bluepylons/Project-152-Bass-Guitar-Amp/panel-connections.txt

Front panel:

(switch)     Power
(5mm LED)    Power
(5mm LED)    Overload
(1/4" jack)  Guitar-in
(switch)     Gain
(knob)       Gain
(knob)       Master Volume

(switch)     Mute 
(switch)     High-pass filter
(switch)     High-pass filter frequency 

(1/8" jack)  Aux in
(1/8" jack)  Headphone out
(knob)       Headphone volume

(knob)       DI send level

Front panel (EQ)
(switch)     Bass peak/shelf
(knob)       Bass level
(knob)       Bass center frequency
(knob)       Low-mid level 
(knob)       Low-mid frequency
(knob)       High-mid level
(knob)       High-mid frequency
(knob)       Treble level
(knob)       Treble frequency

Back panel:		Depth 
(1/4" jack)      EFX out
(1/4" jack)      EFX in
(switch)         DI source 
(switch)         DI ground lift
(XLR)            DI 
(knob)           Balance 
(knob)           Frequency 
(1/4" jack)      Tuner
(IEC connector)  Power In
(1/4" jack)      Woofer
(1/4" jack)      Mids
(1/4" jack)      Tweeter
(Speak-On)       Unified Woofer+Mids

Raw:
Guitar In (1/4" jack)
Power (LED)
Overload (LED)

DI out (XLR)
DI select (switch)
DI ground lift (switch)

Highs (1/4"
Lows (1/4")
Tweeter (1/4"

Gain Sw (toggle sw)
Gain pot (dual 10K)
HPF Bypass (dual switch)
HPF Frequency (dual switch)
EFX Send (1/4" jack) 
EFX Return (1/4" jack)
Aux In (3.5mm jack)
Headphone Out (3.5mm jack)
Tuner Out (1/4" jack)
