bluepylons/Project-152-Bass-Guitar-Amp/Semiparametric-EQ/Semiparametric-EQ 2-22.step

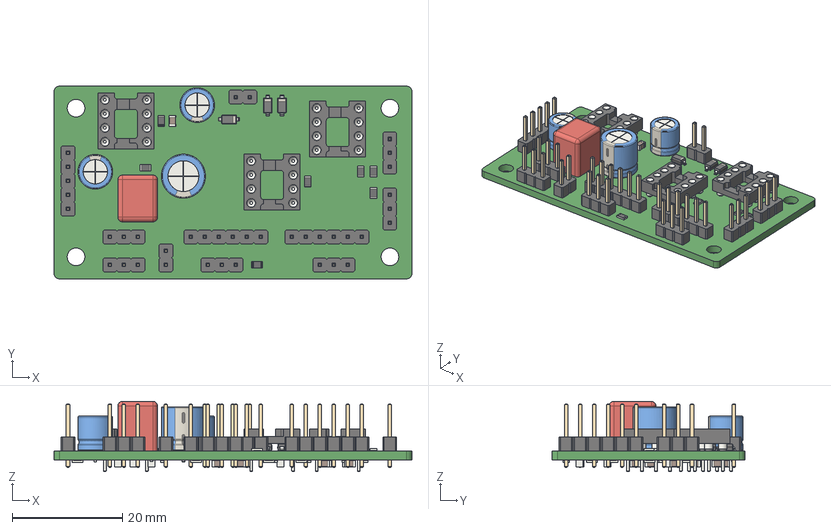
[picture p1: CAD file, 2020-02-23]
Semiparametric-EQ/Semiparametric-EQ 2-22.step
65.0 x 35.0 x 12.8 mm
