bluepylons/Project-152-Bass-Guitar-Amp/power_supply/power_supply.kicad_pcb

## KiCad design power_supply/power_supply.kicad_pcb (2020-02-27)

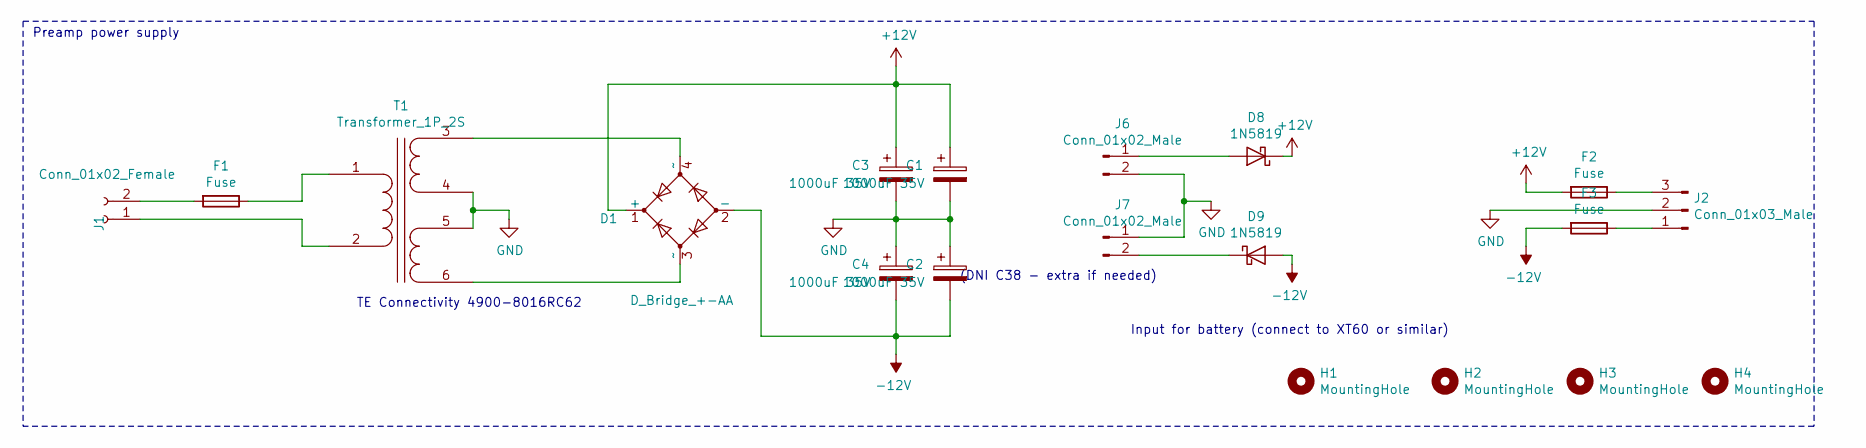
[picture p2: schematic power_supply.sch]

Parts:
C1, C2, C3, C4: 1000uF 35V; CP_Radial_D10.0mm_P5.00mm
D1: D_Bridge_+-AA; DiodesIncDF-M
D8, D9: 1N5819; D_DO-41_SOD81_P10.16mm_Horizontal
F1: Fuse; Keystone-3527-Fuseholder
F2, F3: Fuse; Fuseholder_Blade_Mini_Keystone_3568
H1, H2, H3, H4: MountingHole; MountingHole_3.2mm_M3_DIN965
J1: Conn_01x02_Female; TerminalBlock_Dinkle_DT-55-B01X-02_P10.00mm
J2: Conn_01x03_Male; PinHeader_1x03_P2.54mm_Vertical
J6, J7: Conn_01x02_Male; TerminalBlock_Phoenix_PT-1,5-2-5.0-H_1x02_P5.00mm_Horizontal
T1: Transformer_1P_2S; TE490080XXRC62

Connections:
+12V: C1.1, C3.1, D1.1 (+), D8.1 (K), F2.2
-12V: C2.2, C4.2, D1.2 (-), D9.2 (A), F3.2
GND: C1.2, C2.1, C3.2, C4.1, J2.2, J6.2, J7.1, T1.4 (SB), T1.5 (SC)
unnamed: D1.3 (~~), T1.6 (SD)
unnamed: D1.4 (~~), T1.3 (SA)
unnamed: D8.2 (A), J6.1
unnamed: D9.1 (K), J7.2
unnamed: F1.1, T1.1 (AA)
unnamed: F1.2, J1.2
unnamed: F2.1, J2.3
unnamed: F3.1, J2.1
unnamed: J1.1, T1.2 (AB)

Notes on the sheet:
TE Connectivity 4900-8016RC62
Input for battery (connect to XT60 or similar)
Preamp power supply
(DNI C38 - extra if needed)

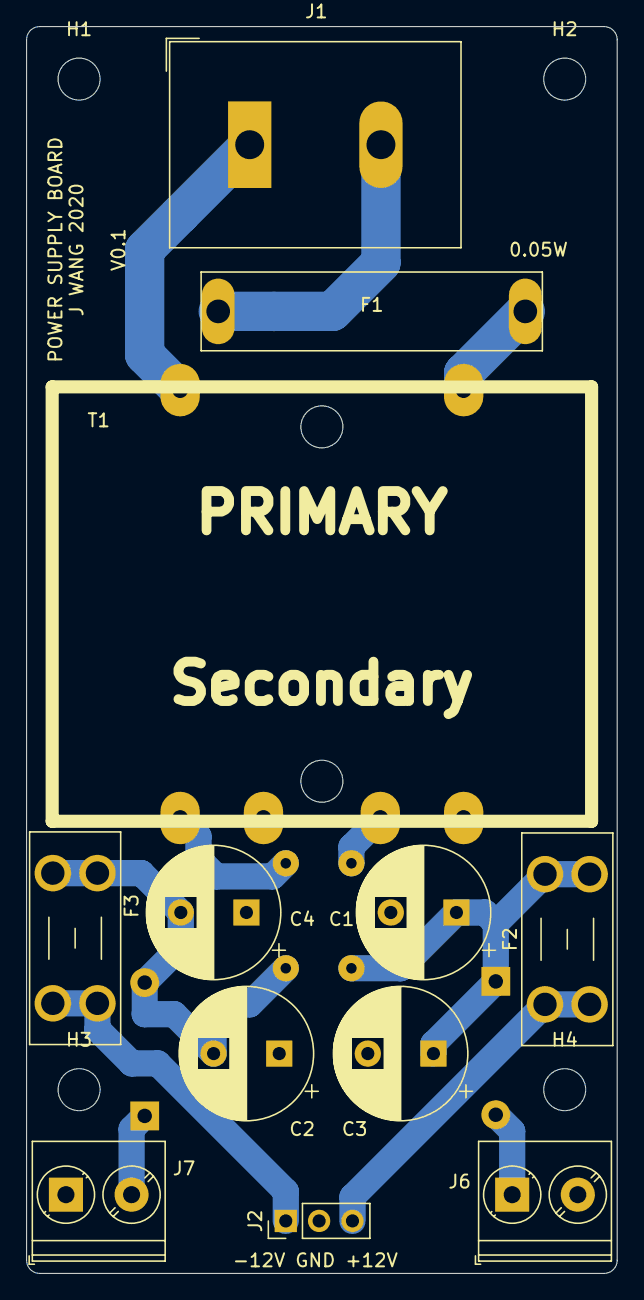
[picture p3: board power_supply.kicad_pcb from above]

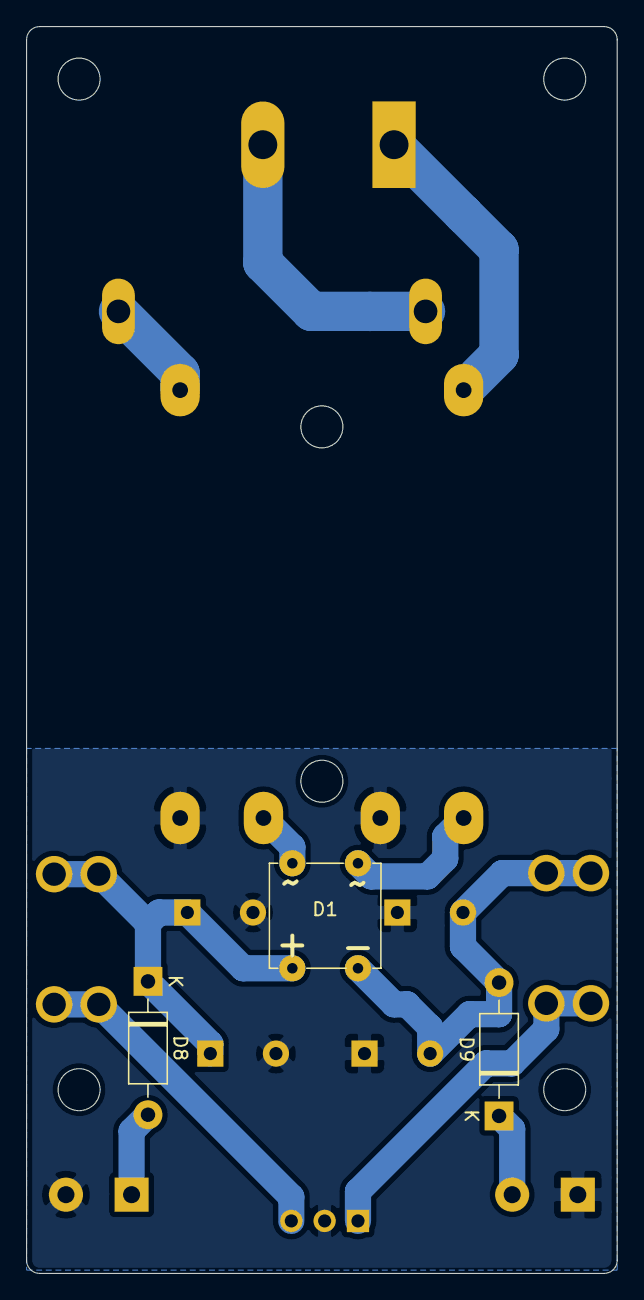
[picture p4: board power_supply.kicad_pcb from below]

Board: 2 copper layers, 45.0 x 95.0 mm, 19 parts (3 on the bottom side), 12 nets.
