bluepylons/Project-152-Bass-Guitar-Amp/Preamp/Preamplifier.kicad_pcb

## KiCad design Preamp/Preamplifier.kicad_pcb (2020-02-23)

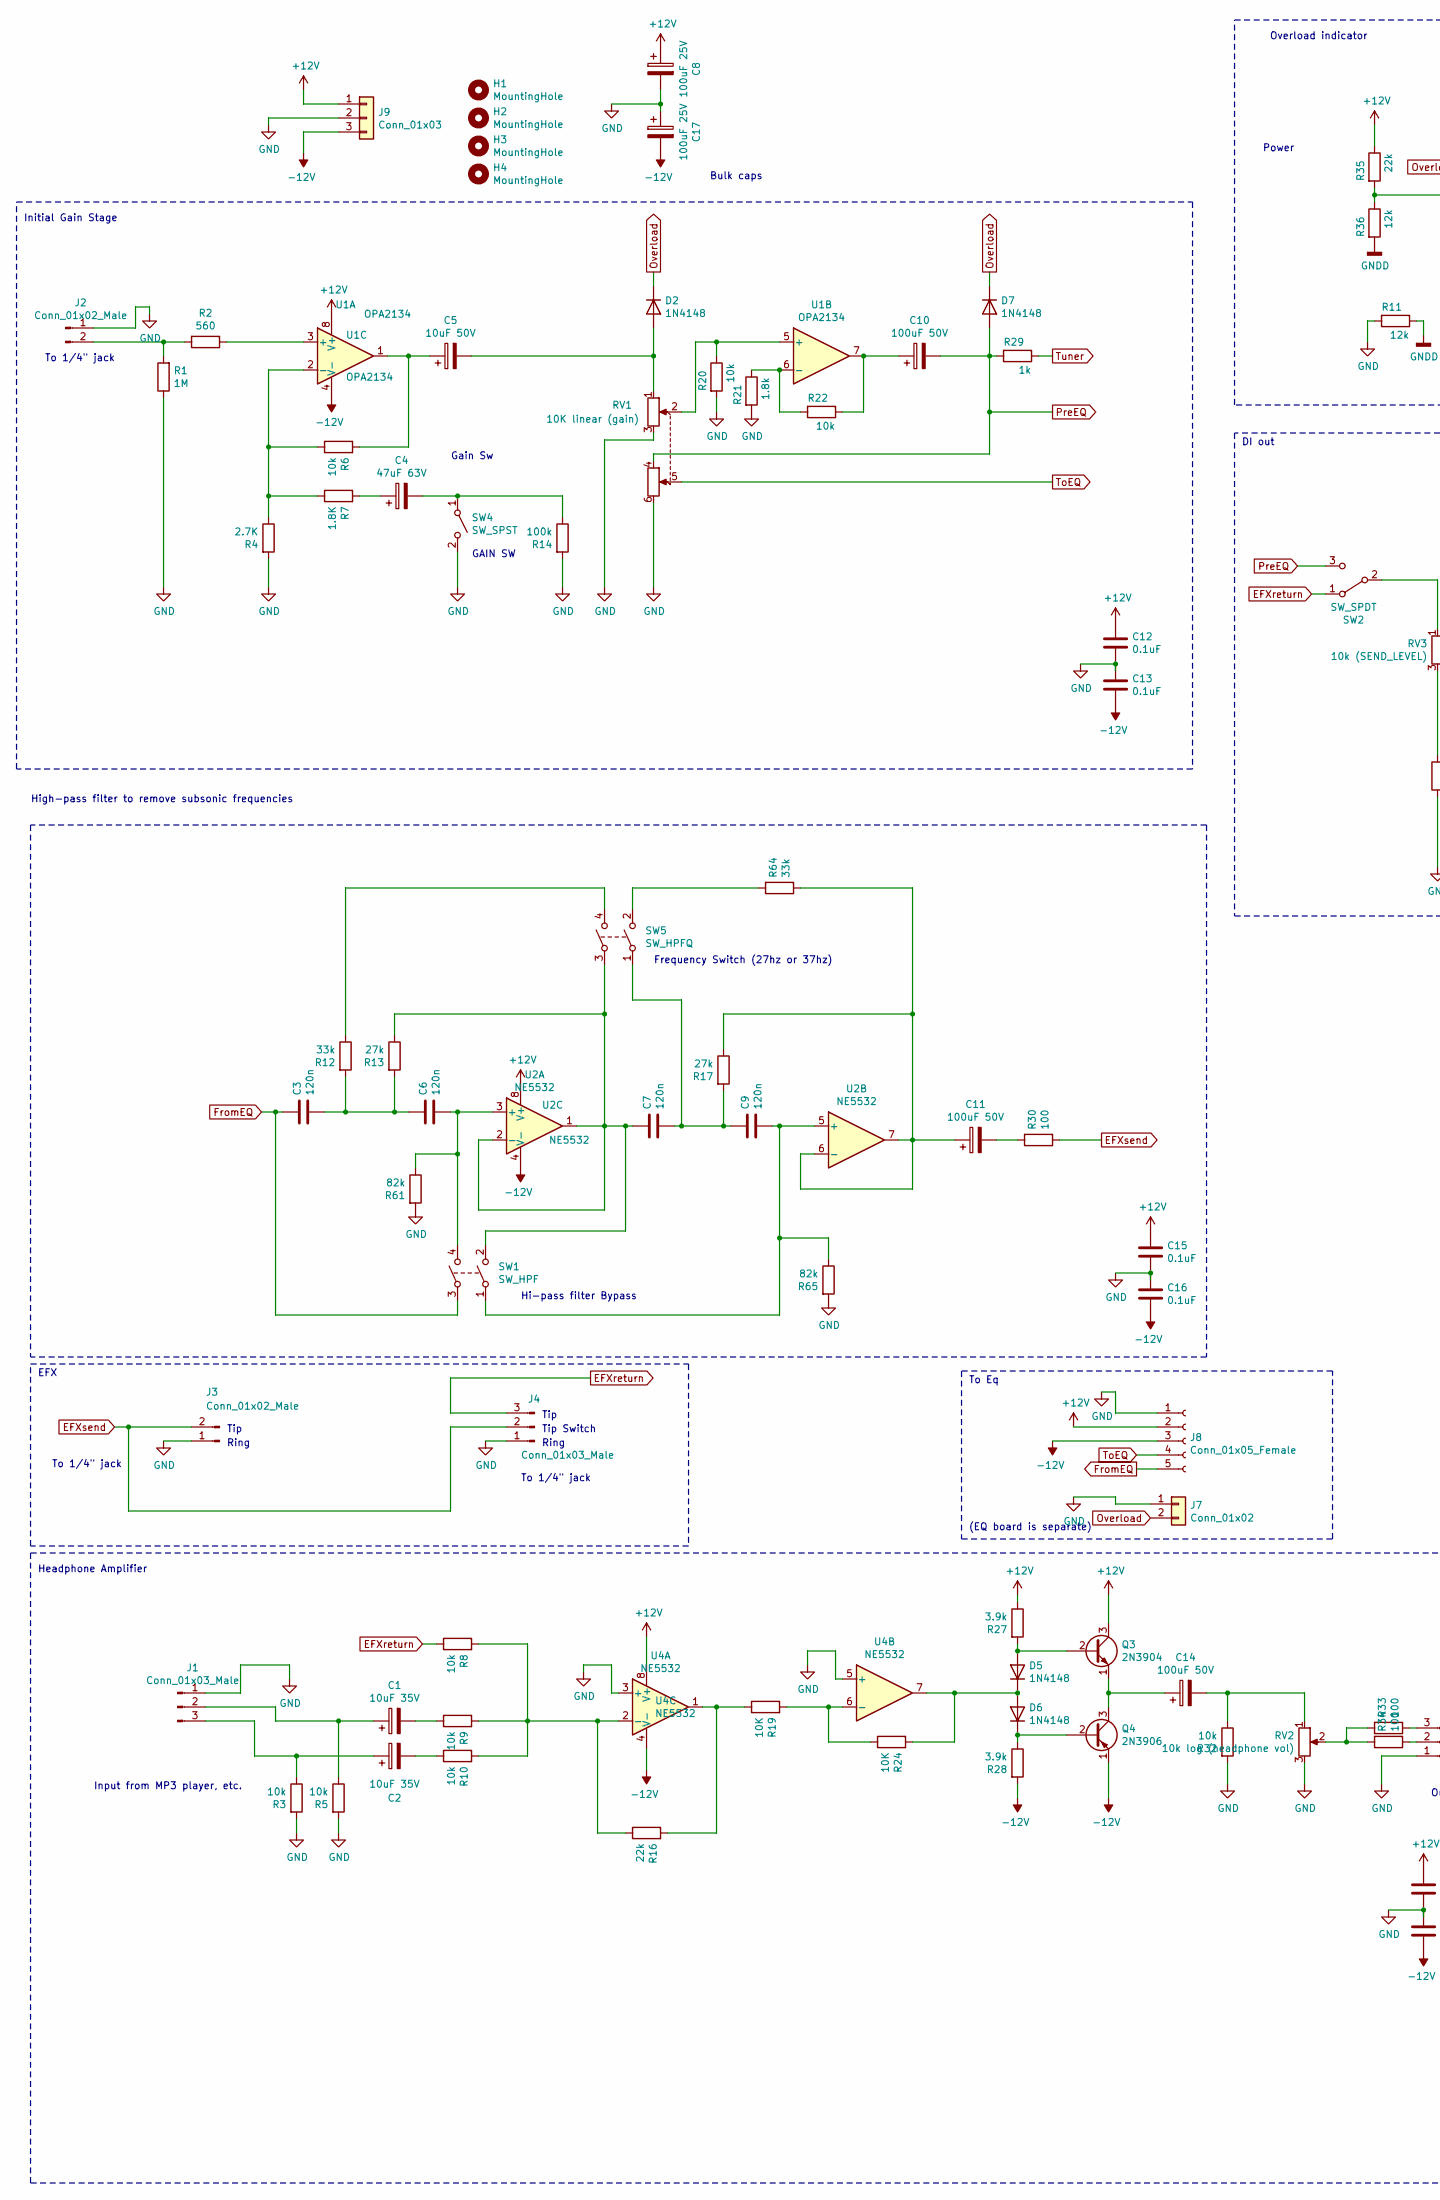
[picture p5: schematic Preamplifier.kicad_sch, part in row 1, column 1]

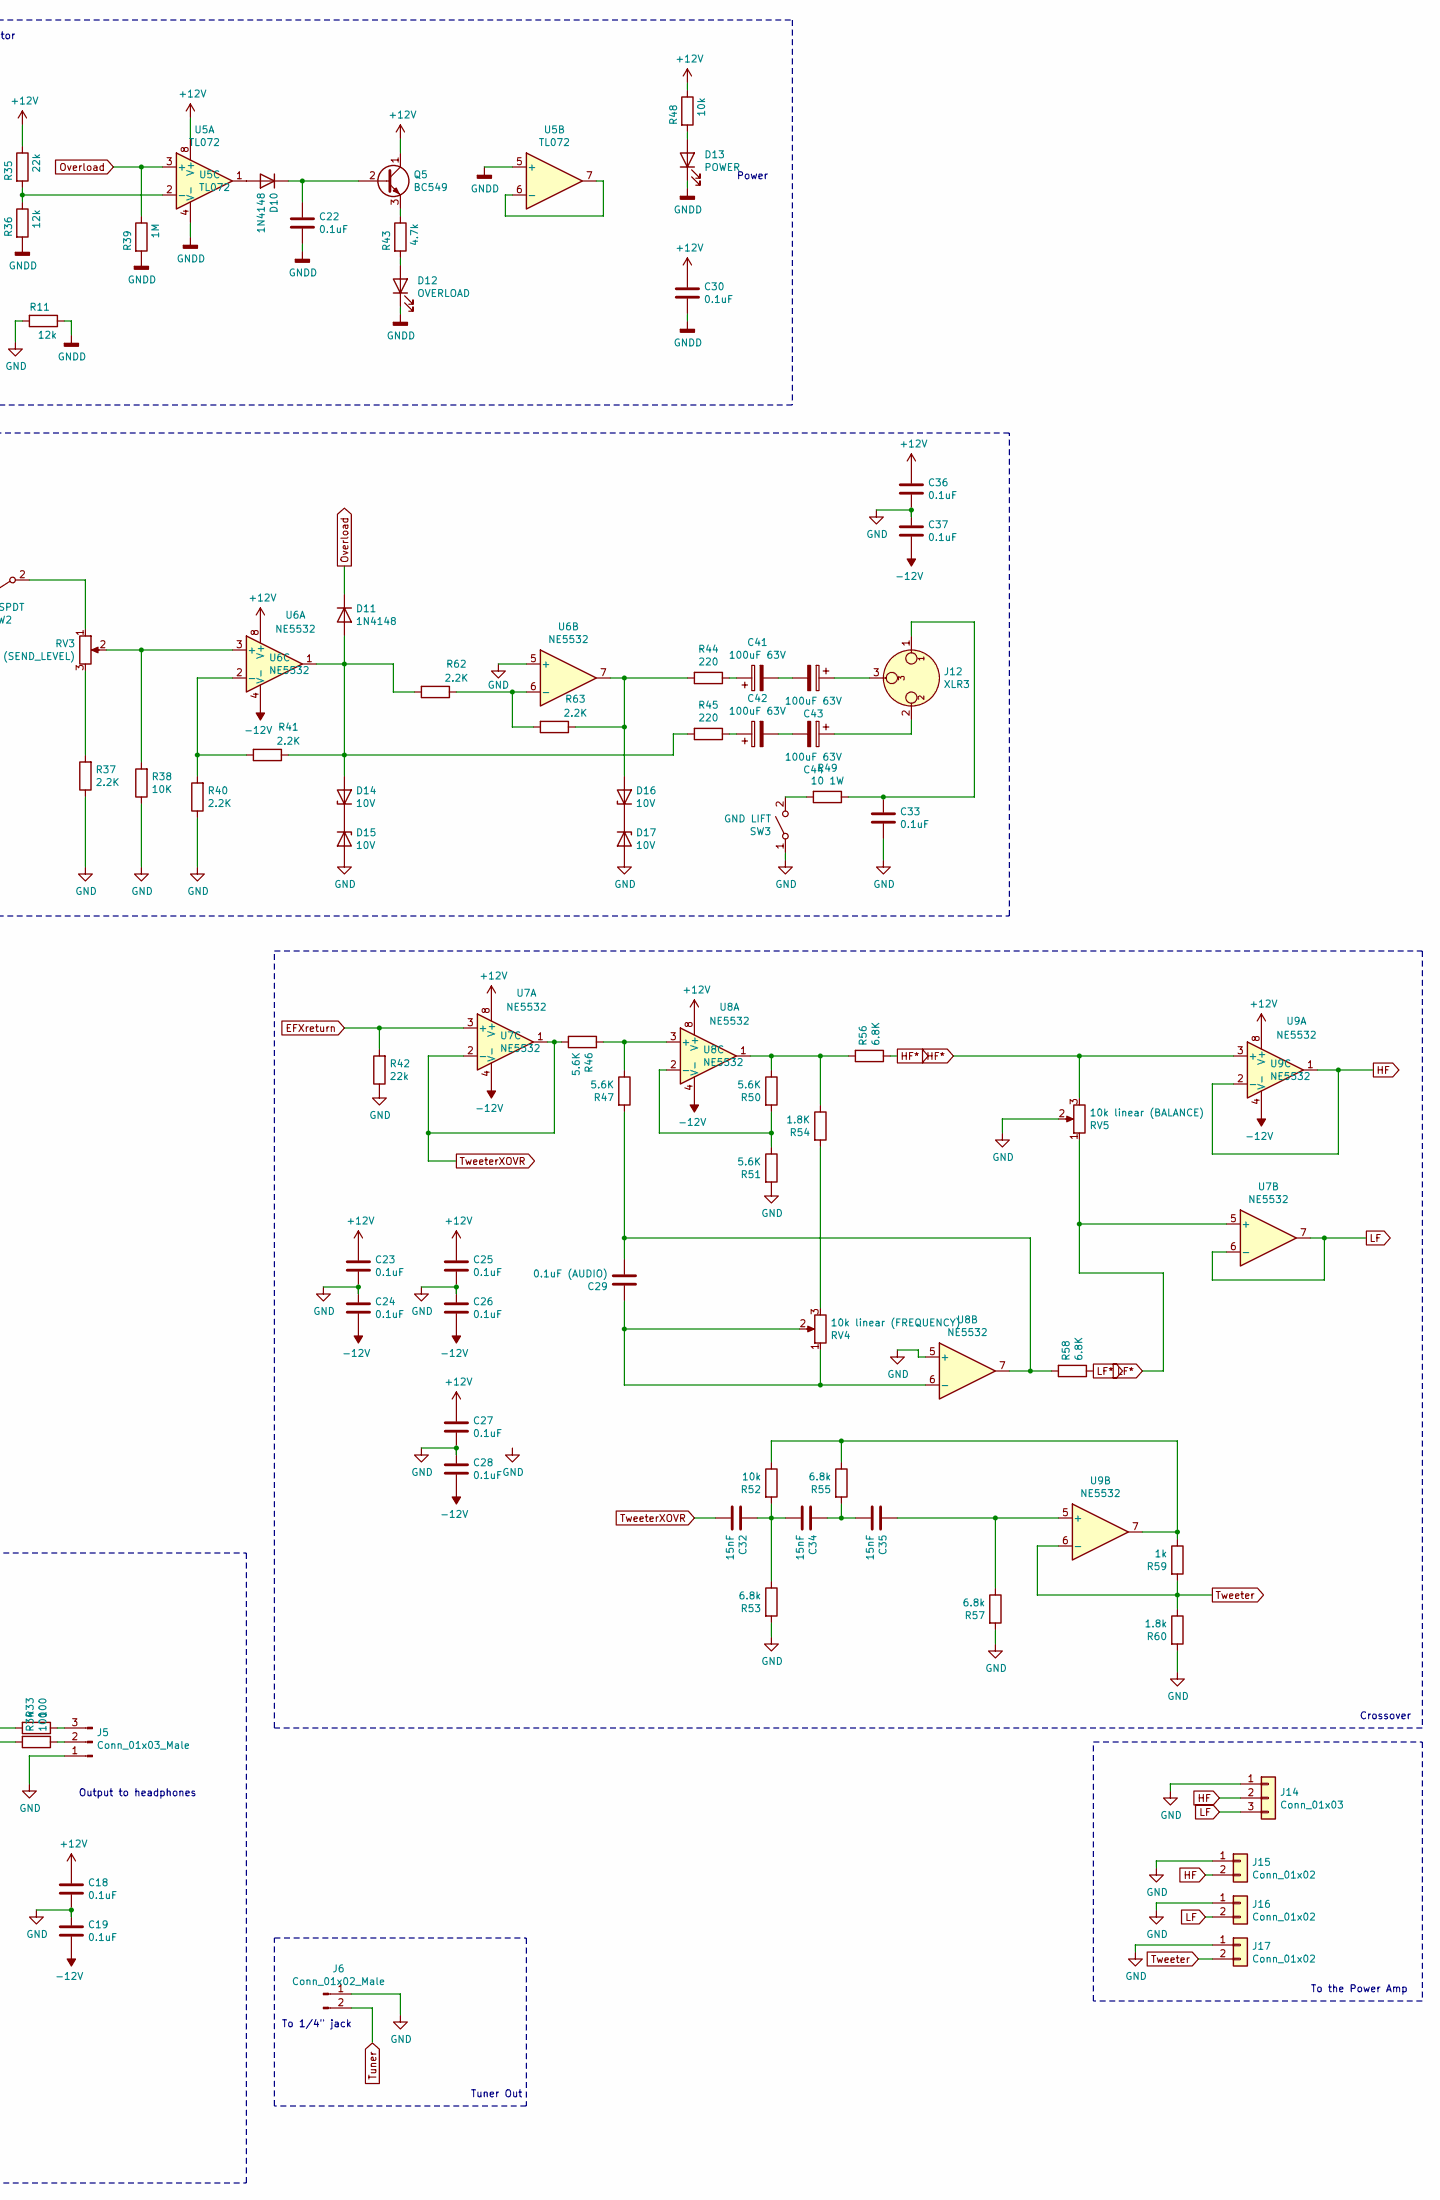
[picture p6: schematic Preamplifier.kicad_sch, part in row 1, column 2]

Parts:
C1, C2: 10uF 35V; CP_Radial_D5.0mm_P2.00mm
C3, C6, C7, C9: 120n; C_Rect_L7.2mm_W3.5mm_P5.00mm_FKS2_FKP2_MKS2_MKP2
C4: 47uF 63V; CP_Radial_D8.0mm_P5.00mm
C5: 10uF 50V; CP_Radial_D6.3mm_P2.50mm
C8, C17: 100uF 25V; CP_Radial_D6.3mm_P2.50mm
C10, C11: 100uF 50V; CP_Radial_D8.0mm_P3.50mm
C12, C13, C15, C16, C18, C19, C22, C23, C24, C25, C26, C27, C28, C30, C33, C36, C37: 0.1uF; C_0805_2012Metric_Pad1.15x1.40mm_HandSolder
C14: 100uF 50V; CP_Radial_D8.0mm_P2.50mm
C29: 0.1uF (AUDIO); C_Rect_L7.2mm_W2.5mm_P5.00mm_FKS2_FKP2_MKS2_MKP2
C32, C34, C35: 15nF; C_Rect_L7.2mm_W2.5mm_P5.00mm_FKS2_FKP2_MKS2_MKP2
C41, C42, C43, C44: 100uF 63V; CP_Radial_D8.0mm_P3.50mm
D2, D5, D6: 1N4148; D_SOD-123
D7, D10, D11: 1N4148; D_DO-35_SOD27_P7.62mm_Horizontal
D12: OVERLOAD; LED_D3.0mm
D13: POWER; LED_D3.0mm
D14, D15, D16, D17: 10V; D_DO-41_SOD81_P7.62mm_Horizontal
H1, H2, H3, H4: MountingHole; MountingHole_3.2mm_M3_ISO7380
J1, J4, J5: Conn_01x03_Male; PinHeader_1x03_P2.54mm_Vertical
J2, J3, J6: Conn_01x02_Male; PinHeader_1x02_P2.54mm_Vertical
J7, J15, J16, J17: Conn_01x02; PinHeader_1x02_P2.54mm_Vertical
J8: Conn_01x05_Female; PinHeader_1x05_P2.54mm_Vertical
J9, J14: Conn_01x03; PinHeader_1x03_P2.54mm_Vertical
J12: XLR3; PinHeader_1x03_P2.54mm_Vertical
Q3: 2N3904; TO-92_Inline
Q4: 2N3906; TO-92_Inline
Q5: BC549; TO-92_Inline
R1, R39: 1M; R_0805_2012Metric_Pad1.15x1.40mm_HandSolder
R2: 560; R_0805_2012Metric_Pad1.15x1.40mm_HandSolder
R3, R5, R6, R8, R9, R10, R20, R22, R32, R48, R52: 10k; R_0805_2012Metric_Pad1.15x1.40mm_HandSolder
R4: 2.7K; R_0805_2012Metric_Pad1.15x1.40mm_HandSolder
R7, R54: 1.8K; R_0805_2012Metric_Pad1.15x1.40mm_HandSolder
R11, R36: 12k; R_0805_2012Metric_Pad1.15x1.40mm_HandSolder
R12, R64: 33k; R_0805_2012Metric_Pad1.15x1.40mm_HandSolder
R13, R17: 27k; R_0805_2012Metric_Pad1.15x1.40mm_HandSolder
R14: 100k; R_0805_2012Metric_Pad1.15x1.40mm_HandSolder
R16, R35, R42: 22k; R_0805_2012Metric_Pad1.15x1.40mm_HandSolder
R19, R24, R38: 10K; R_0805_2012Metric_Pad1.15x1.40mm_HandSolder
R21, R60: 1.8k; R_0805_2012Metric_Pad1.15x1.40mm_HandSolder
R27, R28: 3.9k; R_0805_2012Metric_Pad1.15x1.40mm_HandSolder
R29, R59: 1k; R_0805_2012Metric_Pad1.15x1.40mm_HandSolder
R30, R33, R34: 100; R_1206_3216Metric_Pad1.42x1.75mm_HandSolder
R37, R40, R41, R62, R63: 2.2K; R_0805_2012Metric_Pad1.15x1.40mm_HandSolder
R43: 4.7k; R_0805_2012Metric_Pad1.15x1.40mm_HandSolder
R44, R45: 220; R_1206_3216Metric_Pad1.42x1.75mm_HandSolder
R46, R47, R50, R51: 5.6K; R_0805_2012Metric_Pad1.15x1.40mm_HandSolder
R49: 10 1W; R_Axial_DIN0411_L9.9mm_D3.6mm_P12.70mm_Horizontal
R53, R55, R57: 6.8k; R_0805_2012Metric_Pad1.15x1.40mm_HandSolder
R56, R58: 6.8K; R_0805_2012Metric_Pad1.15x1.40mm_HandSolder
R61, R65: 82k; R_0805_2012Metric_Pad1.15x1.40mm_HandSolder
RV1: 10K linear (gain); PinHeader_1x06_P2.54mm_Vertical
RV2: 10k log (headphone vol); PinHeader_1x03_P2.54mm_Vertical
RV3: 10k (SEND_LEVEL); PinHeader_1x03_P2.54mm_Vertical
RV4: 10k linear (FREQUENCY); RM-065-TRIMPOT
RV5: 10k linear (BALANCE); RM-065-TRIMPOT
SW1: SW_HPF; PinHeader_2x02_P2.54mm_Vertical
SW2: SW_SPDT; PinHeader_1x03_P2.54mm_Vertical
SW3: GND LIFT; PinHeader_1x02_P2.54mm_Vertical
SW4: SW_SPST; PinHeader_1x02_P2.54mm_Vertical
SW5: SW_HPFQ; PinHeader_2x02_P2.54mm_Vertical
U1: OPA2134; DIP-8_W7.62mm_Socket
U2, U4, U6, U7, U8, U9: NE5532; DIP-8_W7.62mm_Socket
U5: TL072; DIP-8_W7.62mm_Socket

Connections:
+12V: C8.1, C12.2, C15.2, C18.2, C23.2, C25.2, C27.2, C30.2, C36.2, J8.2, J9.1, Q3.3 (C), Q5.1 (C), R27.1, R35.1, R48.1, U1.8 (V+), U2.8 (V+), U4.8 (V+), U5.8 (V+), U6.8 (V+), U7.8 (V+), U8.8 (V+), U9.8 (V+)
-12V: C13.1, C16.1, C17.2, C19.1, C24.1, C26.1, C28.1, C37.1, J8.3, J9.3, Q4.1 (E), R28.2, U1.4 (V-), U2.4 (V-), U4.4 (V-), U6.4 (V-), U7.4 (V-), U8.4 (V-), U9.4 (V-)
EFXreturn: J4.3, R8.1, R42.2, SW2.1 (A), U7.3 (+)
EFXsend: J3.2, J4.2, R30.1
FromEQ: C3.2, J8.5, SW1.3
GND: C8.2, C12.1, C13.2, C15.1, C16.2, C17.1, C18.1, C19.2, C23.1, C24.2, C25.1, C26.2, C27.1, C28.2, C33.1, C36.1, C37.2, D15.2 (A), D17.2 (A), J1.1, J2.1, J3.1, J4.1, J5.1, J6.1, J7.1, J8.1, J9.2, J14.1, J15.1, J16.1, J17.1, R1.1, R3.2, R4.2, R5.2, R11.2, R14.2, R20.2, R21.2, R32.2, R37.1, R38.1, R40.1, R42.1, R51.2, R53.2, R57.2, R60.2, R61.2, R65.2, RV1.3, RV1.6, RV2.3, RV5.2, SW3.1 (A), SW4.2 (B), U4.3 (+), U4.5 (+), U6.5 (+), U8.5 (+)
GNDD: C22.1, C30.1, D12.1 (K), D13.1 (K), R11.1, R36.2, R39.2, U5.4 (V-), U5.5 (+)
HF: J14.2, J15.2, U9.1, U9.2 (-)
HF*: R56.1, RV5.3, U9.3 (+)
LF: J14.3, J16.2, U7.6 (-), U7.7
LF*: R58.1, RV5.1, U7.5 (+)
unnamed: C1.1, J1.2, R5.1
unnamed: C1.2, R9.1
unnamed: C2.1, J1.3, R3.1
unnamed: C2.2, R10.1
unnamed: C3.1, C6.2, R12.2, R13.2
unnamed: C4.1, R7.2
unnamed: C4.2, R14.1, SW4.1 (A)
unnamed: C5.1, R6.2, U1.1
unnamed: C5.2, D2.2 (A), RV1.1
unnamed: C6.1, R61.1, SW1.4, U2.3 (+)
unnamed: C7.1, C9.2, R17.2, SW5.1
unnamed: C7.2, R13.1, SW1.2, SW5.3, U2.1, U2.2 (-)
unnamed: C9.1, R65.1, SW1.1, U2.5 (+)
unnamed: C10.1, R22.1, U1.7
unnamed: C11.1, R17.1, R64.1, U2.6 (-), U2.7
unnamed: C11.2, R30.2
unnamed: C14.1, Q3.1 (E), Q4.3 (C)
unnamed: C14.2, R32.1, RV2.1
unnamed: C22.2, D10.1 (K), Q5.2 (B)
unnamed: C29.1, R47.2, R58.2, U8.7
unnamed: C29.2, RV4.1, RV4.2, U8.6 (-)
unnamed: C32.2, C34.1, R52.2, R53.1
unnamed: C33.2, J12.1, R49.1
unnamed: C34.2, C35.1, R55.2
unnamed: C35.2, R57.1, U9.5 (+)
unnamed: C41.1, R44.1
unnamed: C41.2, C43.2
unnamed: C42.1, R45.1
unnamed: C42.2, C44.2
unnamed: C43.1, J12.3
unnamed: C44.1, J12.2
unnamed: D5.1 (K), D6.2 (A), R24.2, U4.7
unnamed: D5.2 (A), Q3.2 (B), R27.2
unnamed: D6.1 (K), Q4.2 (B), R28.1
unnamed: D10.2 (A), U5.1
unnamed: D11.2 (A), D14.2 (A), R41.1, R45.2, R62.2, U6.1
unnamed: D12.2 (A), R43.2
unnamed: D13.2 (A), R48.2
unnamed: D14.1 (K), D15.1 (K)
unnamed: D16.1 (K), D17.1 (K)
unnamed: D16.2 (A), R44.2, R63.1, U6.7
unnamed: J2.2, R1.2, R2.2
unnamed: J5.2, R34.1
unnamed: J5.3, R33.1
unnamed: Q5.3 (E), R43.1
unnamed: R2.1, U1.3 (+)
unnamed: R4.1, R6.1, R7.1, U1.2 (-)
unnamed: R8.2, R9.2, R10.2, R16.1, U4.2 (-)
unnamed: R12.1, SW5.4
unnamed: R16.2, R19.1, U4.1
unnamed: R19.2, R24.1, U4.6 (-)
unnamed: R20.1, RV1.2, U1.5 (+)
unnamed: R21.1, R22.2, U1.6 (-)
unnamed: R33.2, R34.2, RV2.2
unnamed: R35.2, R36.1, U5.2 (-)
unnamed: R37.2, RV3.3
unnamed: R38.2, RV3.2, U6.3 (+)
unnamed: R40.2, R41.2, U6.2 (-)
unnamed: R46.2, R47.1, U8.3 (+)
unnamed: R49.2, SW3.2 (B)
unnamed: R50.1, R54.1, R56.2, U8.1
unnamed: R50.2, R51.1, U8.2 (-)
unnamed: R52.1, R55.1, R59.1, U9.7
unnamed: R54.2, RV4.3
unnamed: R62.1, R63.2, U6.6 (-)
unnamed: R64.2, SW5.2
unnamed: RV3.1, SW2.2 (B)
unnamed: U5.6 (-), U5.7
Overload: D2.1 (K), D7.1 (K), D11.1 (K), J7.2, R39.1, U5.3 (+)
PreEQ: C10.2, D7.2 (A), R29.2, RV1.4, SW2.3 (C)
ToEQ: J8.4, RV1.5
Tuner: J6.2, R29.1
Tweeter: J17.2, R59.2, R60.1, U9.6 (-)
TweeterXOVR: C32.1, R46.1, U7.1, U7.2 (-)

Notes on the sheet:
Initial Gain Stage
High-pass filter to remove subsonic frequencies
EFX
Headphone Amplifier
To 1/4" jack
Input from MP3 player, etc.
Tip
Ring
Gain Sw
GAIN SW
Hi-pass filter Bypass
Tip Switch
Frequency Switch (27hz or 37hz)
Bulk caps
To Eq
(EQ board is separate)
DI out
Power
Overload indicator
Output to headphones
Tuner Out
To the Power Amp
Crossover

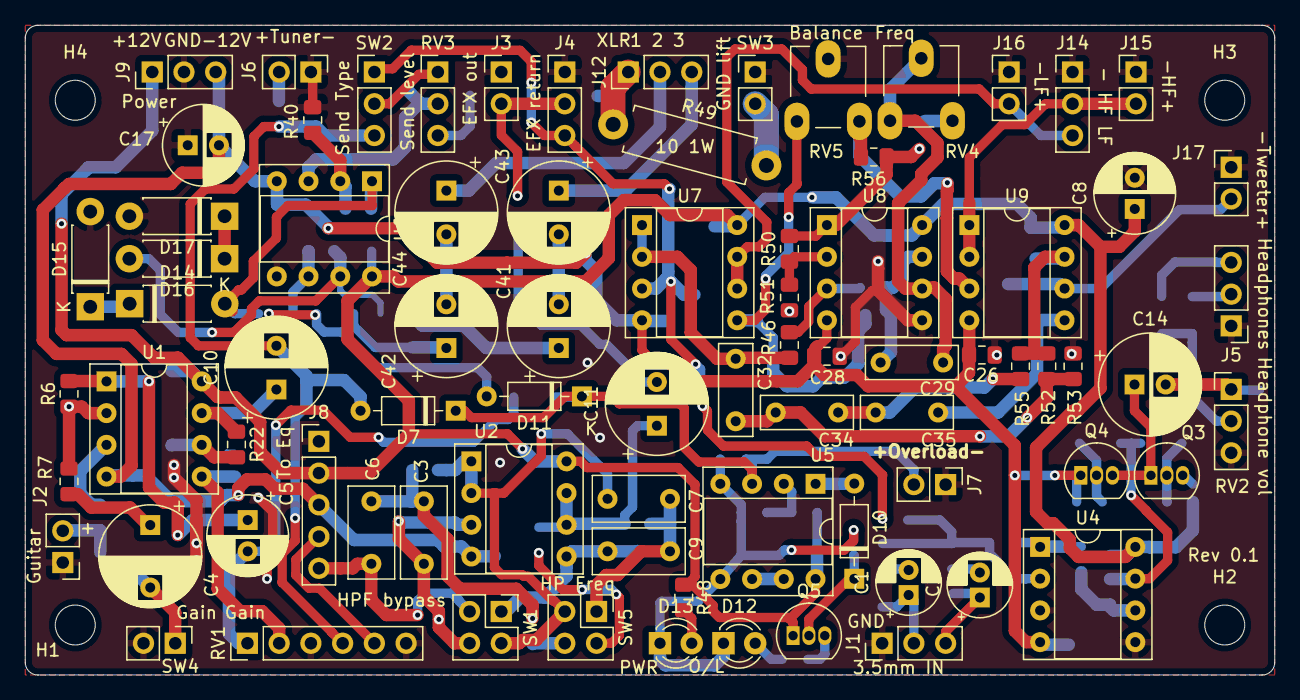
[picture p7: board Preamplifier.kicad_pcb from above]

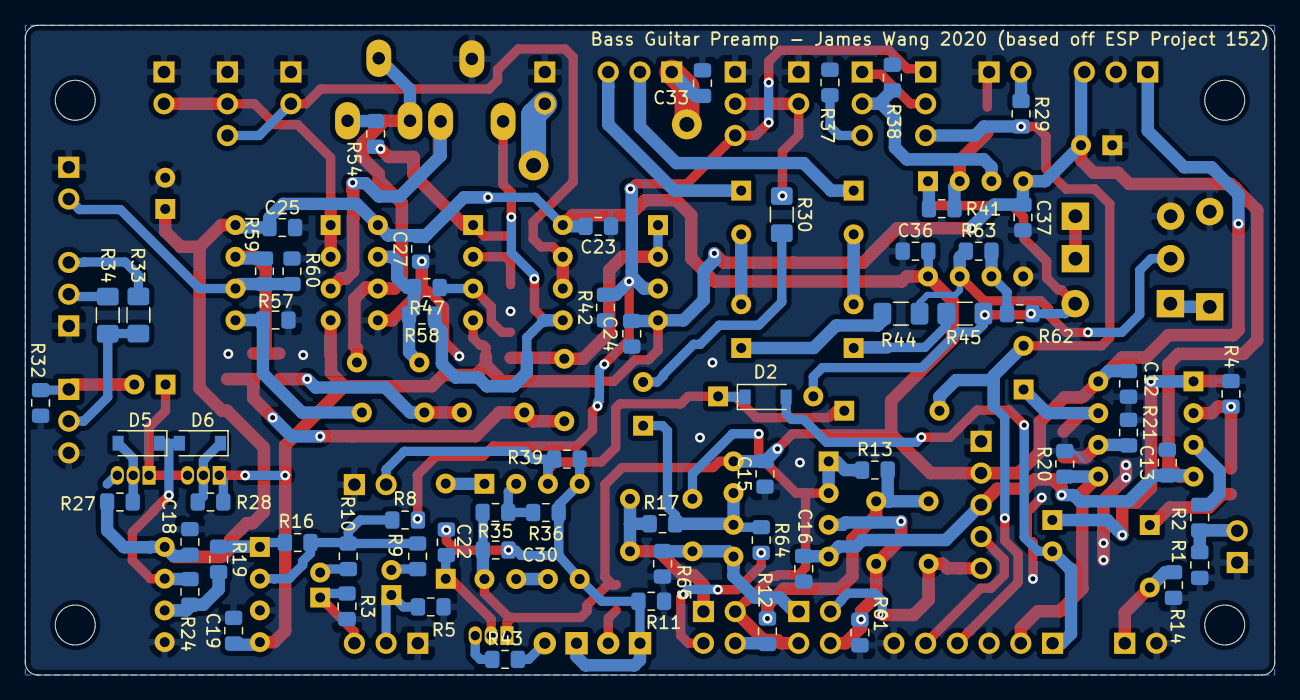
[picture p8: board Preamplifier.kicad_pcb from below]

Board: 2 copper layers, 100.0 x 52.0 mm, 148 parts (64 on the bottom side), 85 nets.
