bluepylons/Project-152-Bass-Guitar-Amp/Semiparametric-EQ/Semiparametric-EQ.kicad_pcb

## KiCad design Semiparametric-EQ/Semiparametric-EQ.kicad_pcb (2020-02-23)

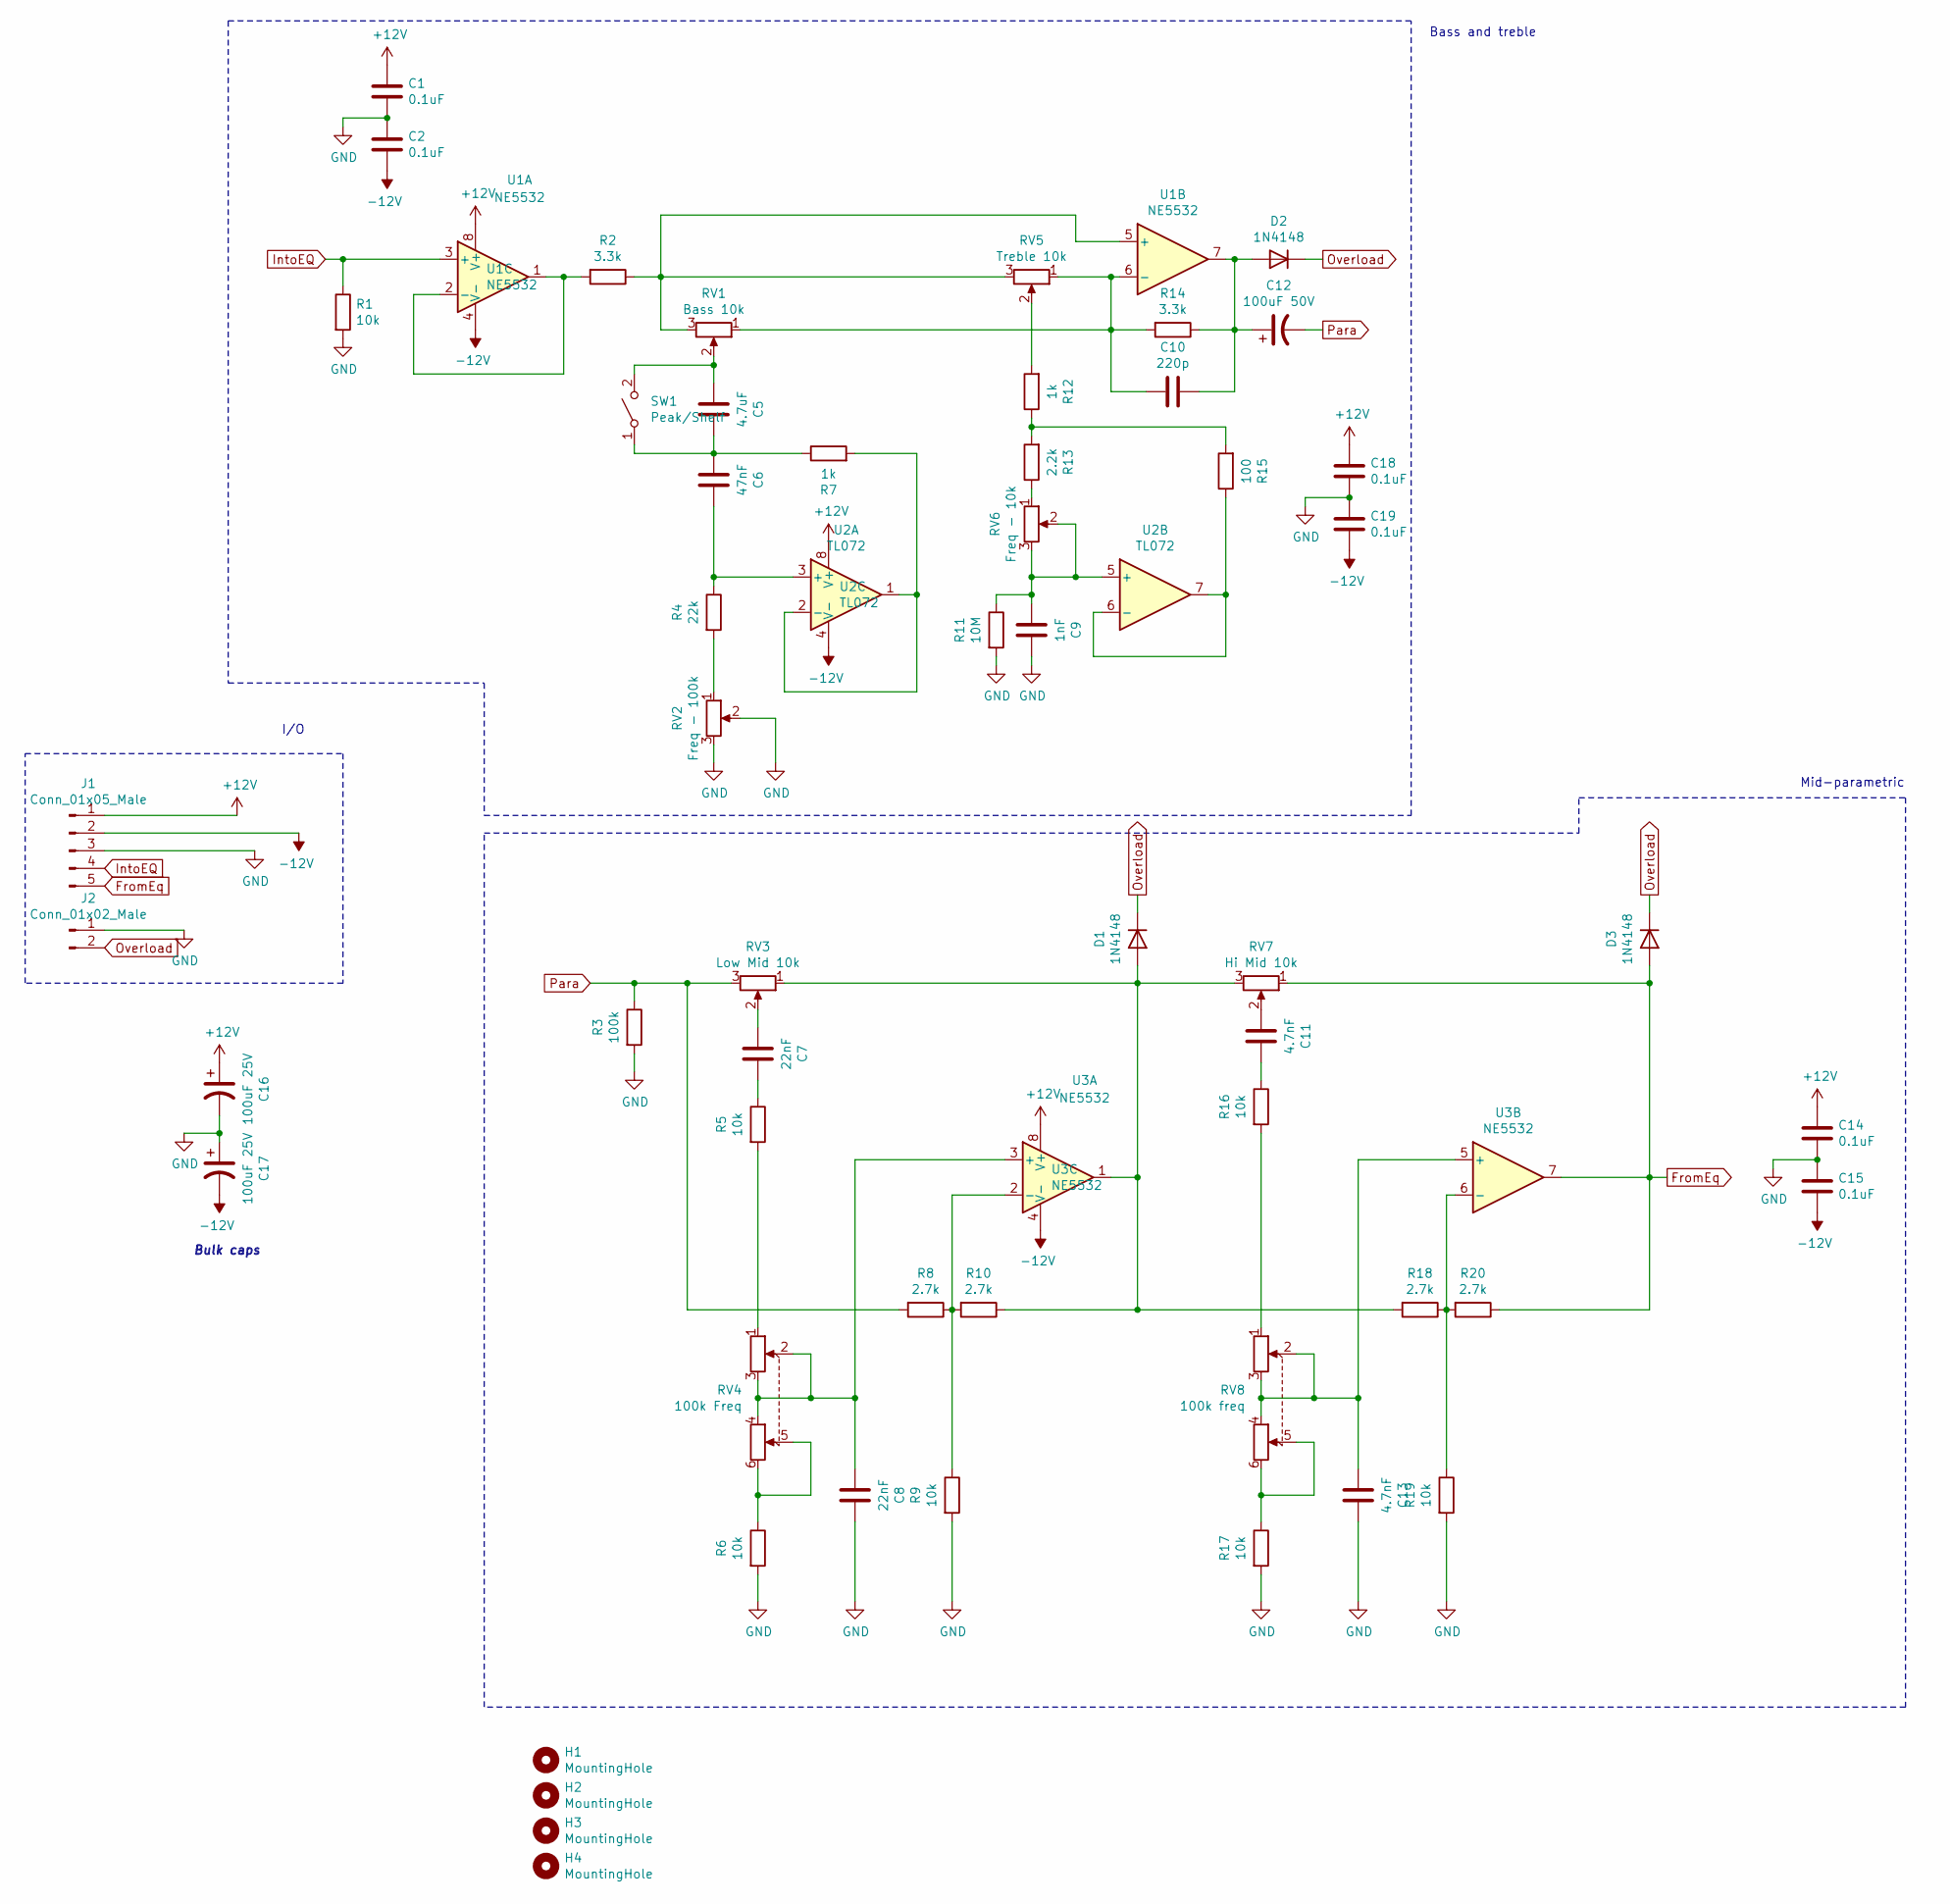
[picture p9: schematic Semiparametric-EQ.kicad_sch]

Parts:
C1, C2, C14, C15, C18, C19: 0.1uF; C_0805_2012Metric_Pad1.15x1.40mm_HandSolder
C5: 4.7uF; C_Rect_L7.2mm_W8.5mm_P5.00mm_FKP2_FKP2_MKS2_MKP2
C6: 47nF; C_0805_2012Metric_Pad1.15x1.40mm_HandSolder
C7, C8: 22nF; C_0805_2012Metric_Pad1.15x1.40mm_HandSolder
C9: 1nF; C_0805_2012Metric_Pad1.15x1.40mm_HandSolder
C10: 220p; C_0805_2012Metric_Pad1.15x1.40mm_HandSolder
C11, C13: 4.7nF; C_0805_2012Metric_Pad1.15x1.40mm_HandSolder
C12: 100uF 50V; CP_Radial_D8.0mm_P3.50mm
C16, C17: 100uF 25V; CP_Radial_D6.3mm_P2.50mm
D1, D2, D3: 1N4148; D_SOD-123
H1, H2, H3, H4: MountingHole; MountingHole_3.2mm_M3_ISO7380
J1: Conn_01x05_Male; PinHeader_1x05_P2.54mm_Vertical
J2: Conn_01x02_Male; PinHeader_1x02_P2.54mm_Vertical
R1, R5, R6, R9, R16, R17, R19: 10k; R_0805_2012Metric_Pad1.15x1.40mm_HandSolder
R2, R14: 3.3k; R_0805_2012Metric_Pad1.15x1.40mm_HandSolder
R3: 100k; R_0805_2012Metric_Pad1.15x1.40mm_HandSolder
R4: 22k; R_0805_2012Metric_Pad1.15x1.40mm_HandSolder
R7, R12: 1k; R_0805_2012Metric_Pad1.15x1.40mm_HandSolder
R8, R10, R18, R20: 2.7k; R_0805_2012Metric_Pad1.15x1.40mm_HandSolder
R11: 10M; R_0805_2012Metric_Pad1.15x1.40mm_HandSolder
R13: 2.2k; R_0805_2012Metric_Pad1.15x1.40mm_HandSolder
R15: 100; R_0805_2012Metric_Pad1.15x1.40mm_HandSolder
RV1: Bass 10k; PinHeader_1x03_P2.54mm_Vertical
RV2: Freq - 100k; PinHeader_1x03_P2.54mm_Vertical
RV3: Low Mid 10k; PinHeader_1x03_P2.54mm_Vertical
RV4: 100k Freq; PinHeader_1x06_P2.54mm_Vertical
RV5: Treble 10k; PinHeader_1x03_P2.54mm_Vertical
RV6: Freq - 10k; PinHeader_1x03_P2.54mm_Vertical
RV7: Hi Mid 10k; PinHeader_1x03_P2.54mm_Vertical
RV8: 100k freq; PinHeader_1x06_P2.54mm_Vertical
SW1: Peak/Shelf; PinHeader_1x02_P2.54mm_Vertical
U1, U3: NE5532; DIP-8_W7.62mm_Socket
U2: TL072; DIP-8_W7.62mm_Socket

Connections:
+12V: C1.1, C14.1, C16.1, C18.1, J1.1, U1.8 (V+), U2.8 (V+), U3.8 (V+)
-12V: C2.2, C15.2, C17.2, C19.2, J1.2, U1.4 (V-), U2.4 (V-), U3.4 (V-)
FromEq: D3.2 (A), J1.5, R20.1, RV7.1, U3.7
GND: C1.2, C2.1, C8.1, C9.1, C13.1, C14.2, C15.1, C16.2, C17.1, C18.2, C19.1, J1.3, J2.1, R1.2, R3.2, R6.2, R9.2, R11.2, R17.2, R19.2, RV2.2, RV2.3
IntoEQ: J1.4, R1.1, U1.3 (+)
unnamed: C5.1, C6.2, R7.1, SW1.1 (A)
unnamed: C5.2, RV1.2, SW1.2 (B)
unnamed: C6.1, R4.1, U2.3 (+)
unnamed: C7.1, R5.1
unnamed: C7.2, RV3.2
unnamed: C8.2, RV4.2, RV4.3, RV4.4, U3.3 (+)
unnamed: C9.2, R11.1, RV6.2, RV6.3, U2.5 (+)
unnamed: C10.1, C12.1, D2.2 (A), R14.1, U1.7
unnamed: C10.2, R14.2, RV1.1, RV5.1, U1.6 (-)
unnamed: C11.1, R16.1
unnamed: C11.2, RV7.2
unnamed: C13.2, RV8.2, RV8.3, RV8.4, U3.5 (+)
unnamed: D1.2 (A), R10.1, R18.2, RV3.1, RV7.3, U3.1
unnamed: R2.1, RV1.3, RV5.3, U1.5 (+)
unnamed: R2.2, U1.1, U1.2 (-)
unnamed: R4.2, RV2.1
unnamed: R5.2, RV4.1
unnamed: R6.1, RV4.5, RV4.6
unnamed: R7.2, U2.1, U2.2 (-)
unnamed: R8.1, R9.1, R10.2, U3.2 (-)
unnamed: R12.1, R13.2, R15.2
unnamed: R12.2, RV5.2
unnamed: R13.1, RV6.1
unnamed: R15.1, U2.6 (-), U2.7
unnamed: R16.2, RV8.1
unnamed: R17.1, RV8.5, RV8.6
unnamed: R18.1, R19.1, R20.2, U3.6 (-)
Overload: D1.1 (K), D2.1 (K), D3.1 (K), J2.2
Para: C12.2, R3.1, R8.2, RV3.3

Notes on the sheet:
Bulk caps
I/O
Bass and treble
Mid-parametric
