bluepylons/Project-152-Bass-Guitar-Amp/Semiparametric-EQ/Semiparametric-EQ.kicad_pcb

## KiCad design Semiparametric-EQ/Semiparametric-EQ.kicad_pcb (continued)

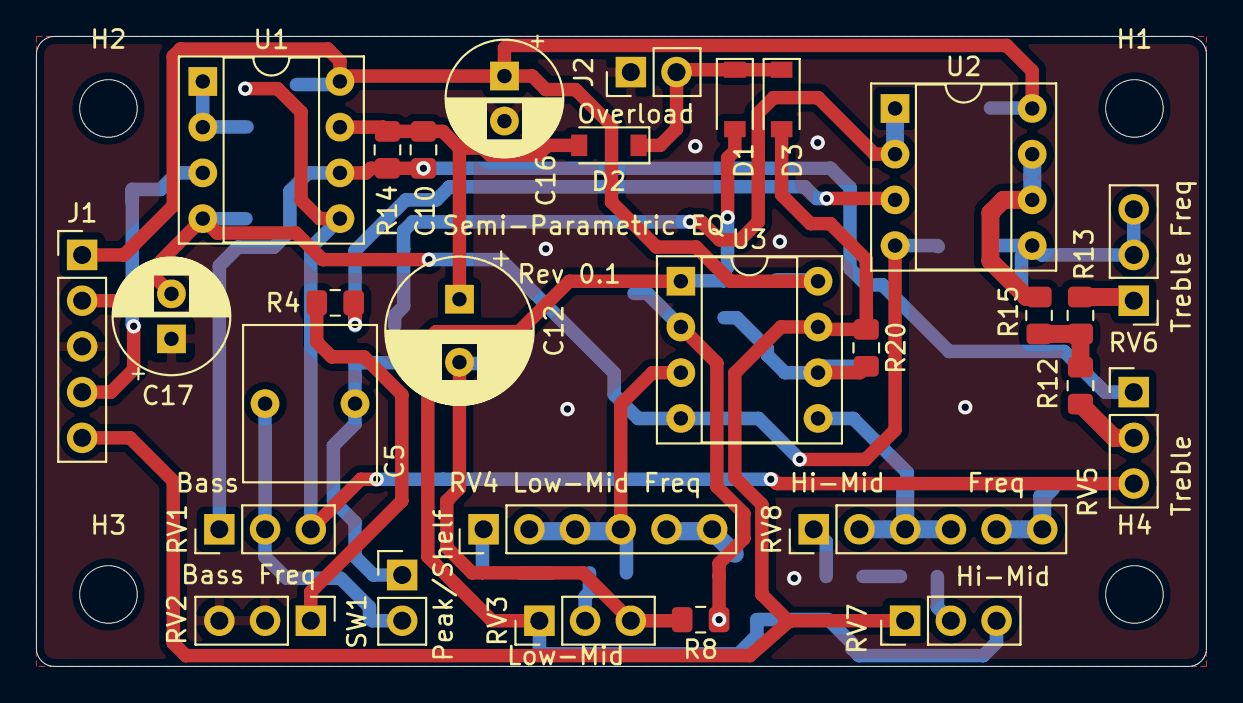
[picture p10: board Semiparametric-EQ.kicad_pcb from above]

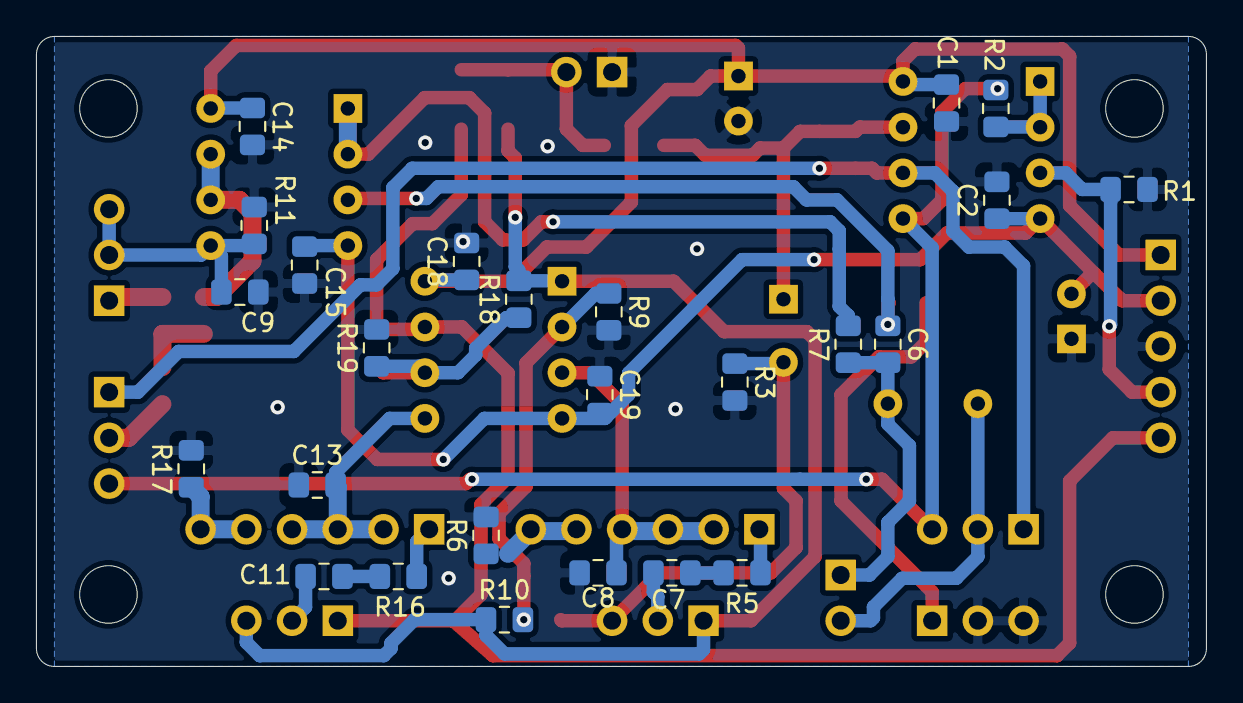
[picture p11: board Semiparametric-EQ.kicad_pcb from below]

Board: 2 copper layers, 65.0 x 35.0 mm, 58 parts (25 on the bottom side), 34 nets.
