bluepylons/Project-152-Bass-Guitar-Amp/(commit log)

2019-12-29 Did more work on amplifier
    [Preamplifier.kicad_pcb, Preamplifier.sch]
2020-01-09 Moved power supply off the main board
    [Preamplifier.kicad_pcb, Preamplifier.sch, power_supply.kicad_pcb, power_supply.sch]
2020-01-19 Moved power supply off preamp
    [Preamplifier.sch, power_supply.sch]
2020-01-20 Did some layout
    [Preamplifier.kicad_pcb, Preamplifier.sch]
2020-01-21 More layout work
    Also fixed some minor issues on the schematic
    [Preamplifier.kicad_pcb, Preamplifier.sch]
2020-01-22 More layout progress
    [Preamplifier.kicad_pcb, Preamplifier.sch]
2020-01-27 Did more layout work
    [Preamplifier.kicad_pcb, Preamplifier.sch]
2020-01-28 More layout work
    [Preamplifier.kicad_pcb]
2020-02-01 Moar layout
    [Preamplifier.kicad_pcb]
2020-02-05 More layout
    [Preamplifier-with-pots.kicad_pcb, Preamplifier-with-pots.sch]
2020-02-15 More layout work
    Still need to lay out the headphone amplifier.
    [Preamplifier.kicad_pcb, Preamplifier.sch]
2020-02-17 Finished first pass at layout.
    Still need to clean up silkscreen.
    [Preamplifier.kicad_pcb, Preamplifier.sch]
2020-02-17 Cleaned up silk screen + made Gerbers
    [Preamplifier.kicad_pcb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]
2020-02-17 Added overload connector for EQ
    [Preamplifier-B_Cu.gbr, Preamplifier-B_Mask.gbr, Preamplifier-B_Paste.gbr, Preamplifier-B_SilkS.gbr, Preamplifier-Edge_Cuts.gbr, Preamplifier-F_Cu.gbr, Preamplifier-F_Mask.gbr, Preamplifier-F_Paste.gbr]
2020-02-18 Added bulk caps, started eq board layout
    [Preamplifier-B_Cu.gbr, Preamplifier-B_Mask.gbr, Preamplifier-B_Paste.gbr, Preamplifier-B_SilkS.gbr, Preamplifier-Edge_Cuts.gbr, Preamplifier-F_Cu.gbr, Preamplifier-F_Mask.gbr, Preamplifier-F_Paste.gbr]
2020-02-18 More layout work on the EQ unit
    [Semiparametric-EQ.kicad_pcb, Semiparametric-EQ.sch]
2020-02-19 More layout on EQ
    [Semiparametric-EQ.kicad_pcb]
2020-02-20 Finished first pass at Eq board
    [Preamplifier-B_Cu.gbr, Preamplifier-B_Mask.gbr, Preamplifier-B_Paste.gbr, Preamplifier-B_SilkS.gbr, Preamplifier-Edge_Cuts.gbr, Preamplifier-F_Cu.gbr, Preamplifier-F_Mask.gbr, Preamplifier-F_Paste.gbr]
2020-02-23 Added top-side ground plane, started power supply work
    [Preamplifier-B_Cu.gbr, Preamplifier-B_Mask.gbr, Preamplifier-B_Paste.gbr, Preamplifier-B_SilkS.gbr, Preamplifier-Edge_Cuts.gbr, Preamplifier-F_Cu.gbr, Preamplifier-F_Mask.gbr, Preamplifier-F_Paste.gbr]
2020-02-27 Finished power supply layout, sent out for first rev of boards
    [power_supply-B_Cu.gbr, power_supply-B_Mask.gbr, power_supply-B_Paste.gbr, power_supply-B_SilkS.gbr, power_supply-Edge_Cuts.gbr, power_supply-F_Cu.gbr, power_supply-F_Mask.gbr, power_supply-F_Paste.gbr]
